crazyfrog-phongee/Project_1/IMAGES/setup-turbine.jpg

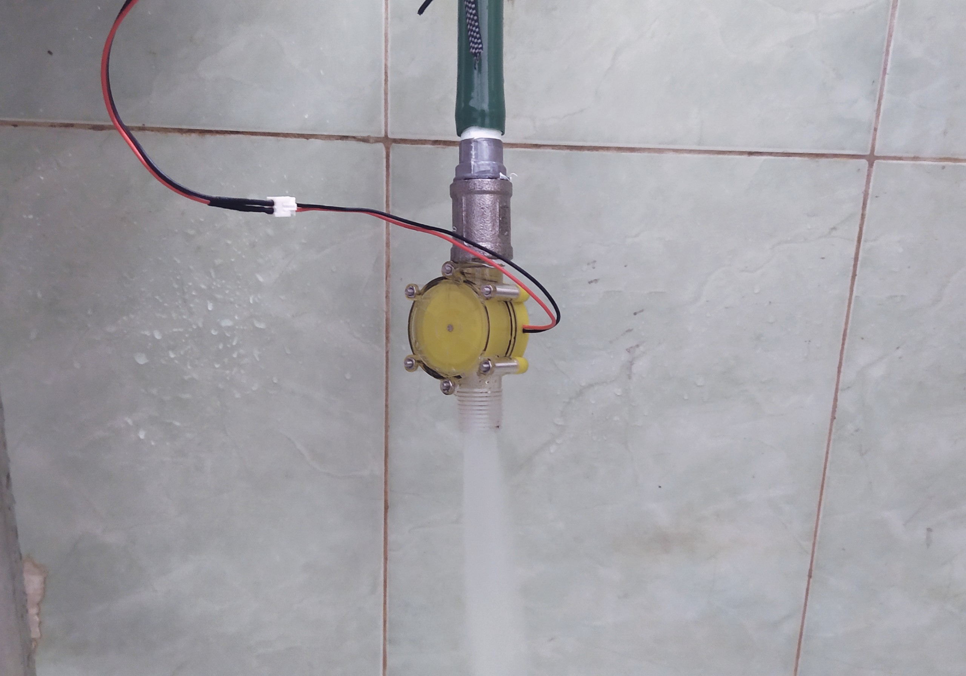
IMAGES/setup-turbine.jpg
