crazyfrog-phongee/Project_1/IMAGES/test-tuabin-voltage.jpg

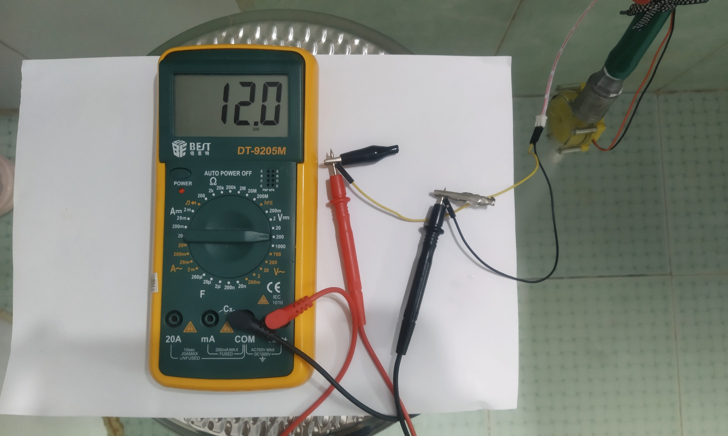
IMAGES/test-tuabin-voltage.jpg
