crazyfrog-phongee/Project_1/IMAGES/diagram.jpg

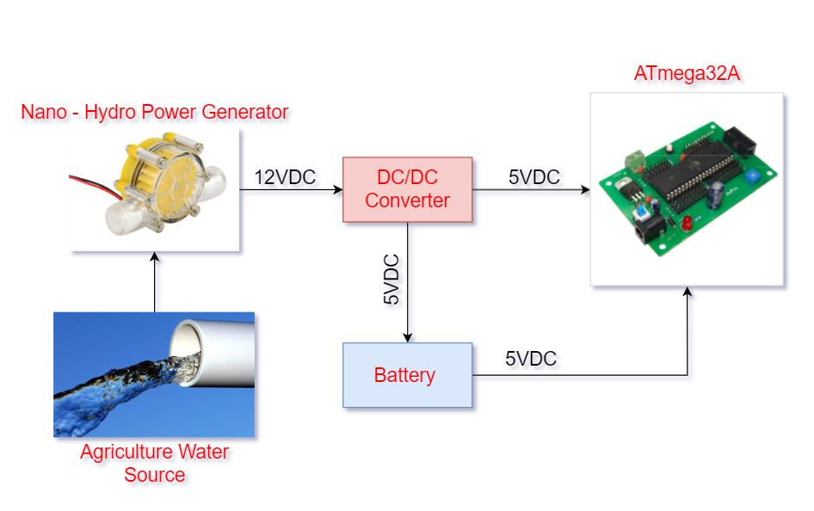
IMAGES/diagram.jpg
