crazyfrog-phongee/Project_1/IMAGES/hienthilcd.jpg

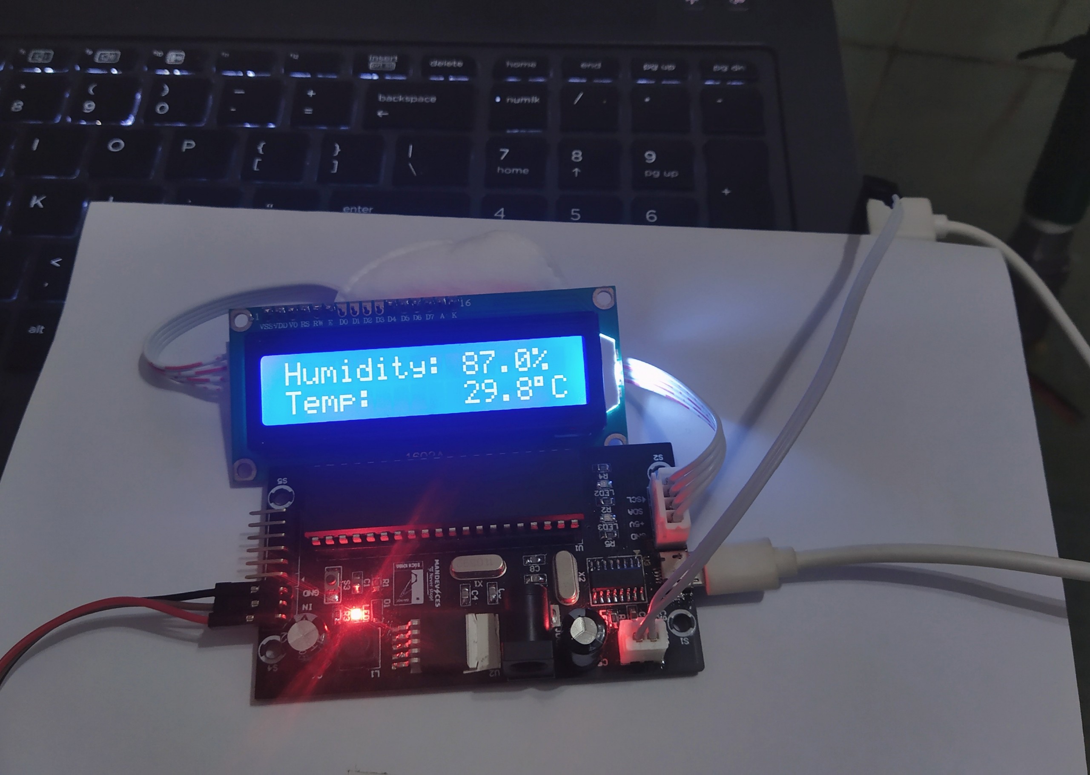
IMAGES/hienthilcd.jpg
