crazyfrog-phongee/Project_1/IMAGES/task_9.5.2022.jpg

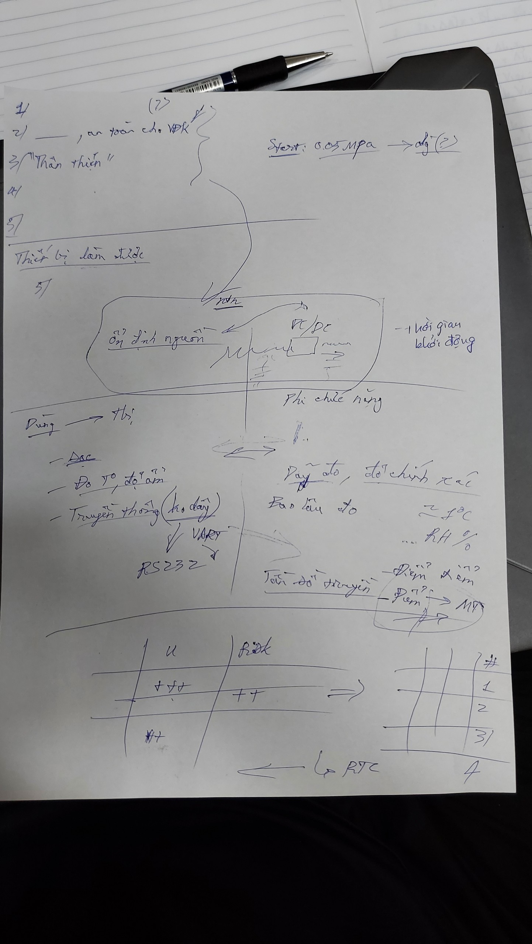
IMAGES/task_9.5.2022.jpg
