crazyfrog-phongee/Project_1/IMAGES/uart.jpg

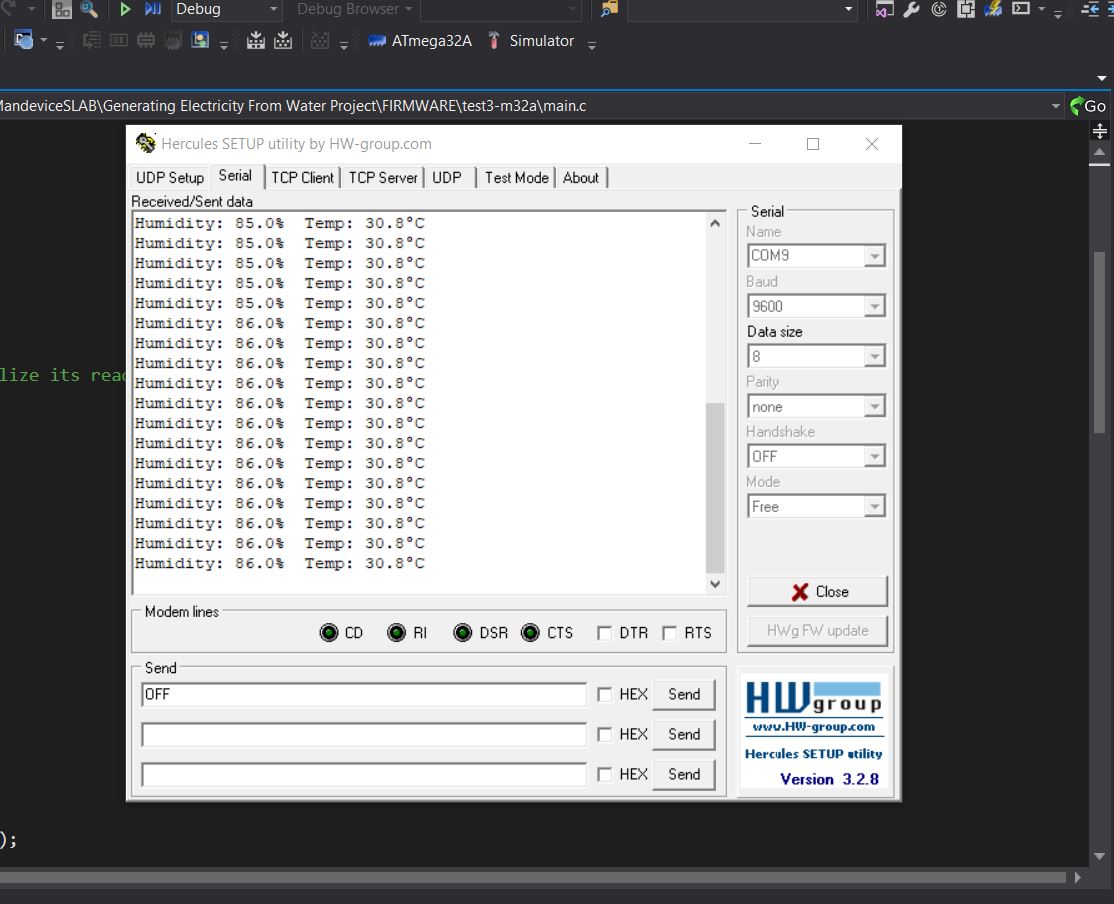
IMAGES/uart.jpg
