crazyfrog-phongee/Project_1/HARDWARE/list-components.xlsx

Danh sách linh kiện
STT | Khối | Tên linh kiện | Số lượng | Link
 | Nguồn
1 |  | Tuabin mini DC 12V/10W | 1 | https://shopee.vn/M%C3%A1y-ph%C3%A1t-%C4%91i%E1%BB%87n-chuy%E1%BB%83n-%C4%91%E1%BB%95i-tuabin-mini-ch%E1%BA%A1y-b%E1%BA%B1ng-s%E1%BB%A9c-n%C6%B0%E1%BB%9Bc-DC-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
2 |  | Module hạ áp Buck DC-DC LM2596 3A | 1 | https://chotroihn.vn/module-buck-dc-dc-lm2596-3a-k1a9-1-10g
3 |  | LM2596S SMD | 1 | https://linhkien.cxt.vn/3384-lm2596s-50-to-263-chinh-hang.html/page-5
4 |  | Jac DC 5.5x2.1mm | 2 | https://linhkien.cxt.vn/1331-jack-dc-55-21mm.html
5 |  | Tụ hóa 100uF 50V | 10 | https://linhkien.cxt.vn/2738-tu-hoa-100uf-50v-8x12mm.html
6 |  | Tụ hóa 220uF 50V | 5 | https://linhkien.cxt.vn/2524-tu-hoa-220uf-50v-8x12mm.html
7 |  | Cuộn cảm 33uH | 5 | https://linhkien.cxt.vn/1175-cd74r-33uh-2a.html
8 |  | Trở 1k5 | 1 dây | https://linhkien.cxt.vn/1056-dien-tro-1k-0805-5-50c.html
 | Truyền thông | USB TO COM CH340 | 1 | https://chotroihn.vn/usb-to-com-ch340
1 |  | IC CH340G | 2 | https://linhkien.cxt.vn/3958-ch340g-ic-transceiver-2mbps-usb20-sop-16.html
2 |  | LED đỏ SMD | 1 dây | https://linhkien.cxt.vn/1306-led-0805-red-trong-suot-10c.html
3 |  | LED xanh dương SMD | 1 dây
4 |  | LED xanh lá cây SMD | 1 dây
5 |  | Cổng USB 2.0 mini | 2 | https://linhkien.cxt.vn/1138-mini-usb-fb-connector.html
6 |  | Crystal 12MHz | 2 | https://linhkien.cxt.vn/1368-thach-anh-12mhz-dip-49s.html
1 | MCU | ATmega16PU | 1 | https://linhkien.cxt.vn/4369-atmega16-16pu-ic-mcu-8bit-16kb-flash-40dip.html
2 |  | Crystal 11.0592MHz | 2
3 |  | 22pF SMD | 1 dây | https://linhkien.cxt.vn/1061-tu-22pf-5-0805.html
4 |  | Resistor 10k SMD 0805 | 1 dây | https://linhkien.cxt.vn/1057-dien-tro-10k-5-0805.html
5 |  | Đế IC 40P | 2 | https://linhkien.cxt.vn/1322-dip-socket-40p.html
6 |  | Tụ 106 SMD | 1 dây | https://linhkien.cxt.vn/1978-tu-khong-phan-cuc-0805.html
7 |  | Nút nhấn 2 chân SMD | 2 | https://linhkien.cxt.vn/5070-nut-nhan-2p-3x4x25h-smd.html
8 |  | Jump đực đơn 1x40P | 1 | https://linhkien.cxt.vn/3907-jump-duc-don-1x40p-254mm-chan-cong-ma-vang.html
9 |  | Header đực 4P | 10 | https://banlinhkien.com/header-4p-xh2.544p-duc-thang-10-chiec-p22290875.html
10 |  | Tụ 104 SMD | 1 gói | https://linhkien.cxt.vn/1974-tu-khong-phan-cuc-0805.html
 |  | Diode 1n5819 | 1 | https://banlinhkien.com/diode-s4-sod123-1n5819-sod123-10c-p16133952.html
 |  | Dây trắng 4P XH2.54-4P 20Cm | 1 | https://banlinhkien.com/day-trang-4p-xh2.544p-20cm-p20816954.html
 |  | MicroUSB MK5P SMD | 1 | https://banlinhkien.com/microusb-mk5p-smd-p6652832.html
