crazyfrog-phongee/Project_1/IMAGES/setup.jpg

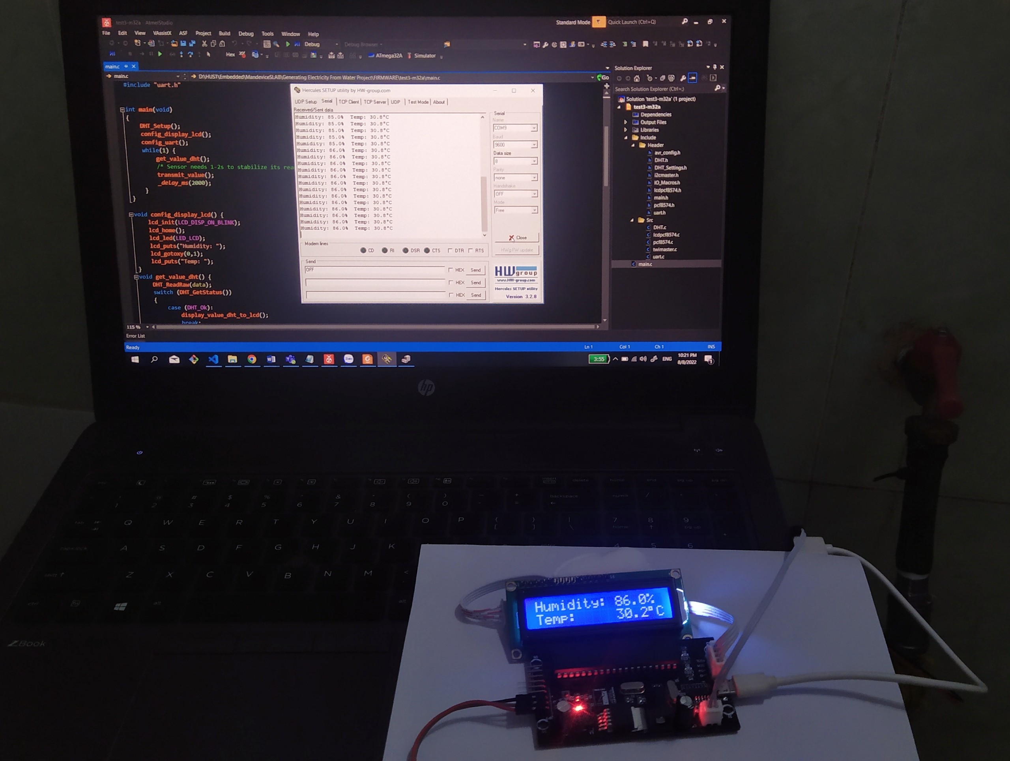
IMAGES/setup.jpg
