crazyfrog-phongee/Project_1/(list of files, drawings)

Other design files:
HARDWARE/Master_Display.SchDoc
HARDWARE/Master_MCU.SchDoc
HARDWARE/Master_Power.SchDoc
HARDWARE/Master_Sensor.SchDoc
HARDWARE/Master_Transmit.SchDoc
HARDWARE/PCB_Project1.PcbDoc
HARDWARE/PCB_Project1.PrjPCB
HARDWARE/Sheet-Connectors.SchDoc
PROTEUS/project-01.pdsprj
