crazyfrog-phongee/Project_1/FIRMWARE/firmware-project-1/Include/Src/lcdpcf8574.c

/*
 * lcdpcf8574 lib 0x03
 * copyright (c) Davide Gironi, 2013
 * Released under GPLv3.
 * Please refer to LICENSE file for licensing information.
*/

#include "avr_config.h"
#include <inttypes.h>
#include <avr/io.h>
#include <avr/pgmspace.h>

#include "pcf8574.h"
#include "lcdpcf8574.h"

#define lcd_e_delay()   __asm__ __volatile__( "rjmp 1f\n 1:" );
#define lcd_e_toggle()  toggle_e()

#if LCD_LINES==1
#define LCD_FUNCTION_DEFAULT    LCD_FUNCTION_4BIT_1LINE 
#else
#define LCD_FUNCTION_DEFAULT    LCD_FUNCTION_4BIT_2LINES 
#endif

volatile uint8_t dataport = 0;

/* 
** function prototypes 
*/
static void toggle_e(void);

/*
** local functions
*/



/*************************************************************************
 delay loop for small accurate delays: 16-bit counter, 4 cycles/loop
*************************************************************************/
static inline void _delayFourCycles(unsigned int __count)
{
    if ( __count == 0 )    
        __asm__ __volatile__( "rjmp 1f\n 1:" );    // 2 cycles
    else
        __asm__ __volatile__ (
    	    "1: sbiw %0,1" "\n\t"                  
    	    "brne 1b"                              // 4 cycles/loop
    	    : "=w" (__count)
    	    : "0" (__count)
    	   );
}


/************************************************************************* 
delay for a minimum of <us> microseconds
the number of loops is calculated at compile-time from MCU clock frequency
*************************************************************************/
#define delay(us)  _delayFourCycles( ( ( 1*(F_CPU/4000) )*us)/1000 )


/* toggle Enable Pin to initiate write */
static void toggle_e(void)
{
	pcf8574_setoutputpinhigh(LCD_PCF8574_DEVICEID, LCD_E_PIN);
    lcd_e_delay();
    pcf8574_setoutputpinlow(LCD_PCF8574_DEVICEID, LCD_E_PIN);
}


/*************************************************************************
Low-level function to write byte to LCD controller
Input:    data   byte to write to LCD
          rs     1: write data    
                 0: write instruction
Returns:  none
*************************************************************************/
static void lcd_write(uint8_t data,uint8_t rs) 
{
	if (rs) /* write data        (RS=1, RW=0) */
		dataport |= _BV(LCD_RS_PIN);
	else /* write instruction (RS=0, RW=0) */
		dataport &= ~_BV(LCD_RS_PIN);
	dataport &= ~_BV(LCD_RW_PIN);
	pcf8574_setoutput(LCD_PCF8574_DEVICEID, dataport);

	/* output high nibble first */
    dataport &= ~_BV(LCD_DATA3_PIN);
    dataport &= ~_BV(LCD_DATA2_PIN);
    dataport &= ~_BV(LCD_DATA1_PIN);
    dataport &= ~_BV(LCD_DATA0_PIN);
	if(data & 0x80) dataport |= _BV(LCD_DATA3_PIN);
	if(data & 0x40) dataport |= _BV(LCD_DATA2_PIN);
	if(data & 0x20) dataport |= _BV(LCD_DATA1_PIN);
	if(data & 0x10) dataport |= _BV(LCD_DATA0_PIN);
	pcf8574_setoutput(LCD_PCF8574_DEVICEID, dataport);
	lcd_e_toggle();

	/* output low nibble */
	dataport &= ~_BV(LCD_DATA3_PIN);
	dataport &= ~_BV(LCD_DATA2_PIN);
	dataport &= ~_BV(LCD_DATA1_PIN);
	dataport &= ~_BV(LCD_DATA0_PIN);
	if(data & 0x08) dataport |= _BV(LCD_DATA3_PIN);
	if(data & 0x04) dataport |= _BV(LCD_DATA2_PIN);
	if(data & 0x02) dataport |= _BV(LCD_DATA1_PIN);
	if(data & 0x01) dataport |= _BV(LCD_DATA0_PIN);
	pcf8574_setoutput(LCD_PCF8574_DEVICEID, dataport);
	lcd_e_toggle();

	/* all data pins high (inactive) */
	dataport |= _BV(LCD_DATA0_PIN);
	dataport |= _BV(LCD_DATA1_PIN);
	dataport |= _BV(LCD_DATA2_PIN);
	dataport |= _BV(LCD_DATA3_PIN);
	pcf8574_setoutput(LCD_PCF8574_DEVICEID, dataport);
}


/*************************************************************************
Low-level function to read byte from LCD controller
Input:    rs     1: read data    
                 0: read busy flag / address counter
Returns:  byte read from LCD controller
*************************************************************************/
static uint8_t lcd_read(uint8_t rs) 
{
    uint8_t data;

    if (rs) /* write data (RS=1, RW=0) */
    	dataport |= _BV(LCD_RS_PIN);
    else /* write instruction (RS=0, RW=0) */
    	dataport &= ~_BV(LCD_RS_PIN);
    dataport |= _BV(LCD_RW_PIN);
    pcf8574_setoutput(LCD_PCF8574_DEVICEID, dataport);

	/* read high nibble first */
    pcf8574_setoutputpinhigh(LCD_PCF8574_DEVICEID, LCD_E_PIN);
	lcd_e_delay();
    data = 0;
    if(!pcf8574_getinputpin(LCD_PCF8574_DEVICEID, LCD_DATA0_PIN)) data |= 0x10;
    if(!pcf8574_getinputpin(LCD_PCF8574_DEVICEID, LCD_DATA1_PIN)) data |= 0x20;
    if(!pcf8574_getinputpin(LCD_PCF8574_DEVICEID, LCD_DATA2_PIN)) data |= 0x40;
    if(!pcf8574_getinputpin(LCD_PCF8574_DEVICEID, LCD_DATA3_PIN)) data |= 0x80;
	pcf8574_setoutputpinlow(LCD_PCF8574_DEVICEID, LCD_E_PIN);

	/* Enable 500ns low */
	lcd_e_delay();

	/* read low nibble */
	pcf8574_setoutputpinhigh(LCD_PCF8574_DEVICEID, LCD_E_PIN);
	lcd_e_delay();
	if(!pcf8574_getinputpin(LCD_PCF8574_DEVICEID, LCD_DATA0_PIN)) data |= 0x01;
	if(!pcf8574_getinputpin(LCD_PCF8574_DEVICEID, LCD_DATA1_PIN)) data |= 0x02;
	if(!pcf8574_getinputpin(LCD_PCF8574_DEVICEID, LCD_DATA2_PIN)) data |= 0x04;
	if(!pcf8574_getinputpin(LCD_PCF8574_DEVICEID, LCD_DATA3_PIN)) data |= 0x08;
	pcf8574_setoutputpinlow(LCD_PCF8574_DEVICEID, LCD_E_PIN);

    return data;
}


/*************************************************************************
loops while lcd is busy, returns address counter
*************************************************************************/
static uint8_t lcd_waitbusy(void)
{
    register uint8_t c;
    
    /* wait until busy flag is cleared */
    while ( (c=lcd_read(0)) & (1<<LCD_BUSY)) {}
    
    /* the address counter is updated 4us after the busy flag is cleared */
    delay(2);

    /* now read the address counter */
    return (lcd_read(0));  // return address counter
    
}/* lcd_waitbusy */


/*************************************************************************
Move cursor to the start of next line or to the first line if the cursor 
is already on the last line.
*************************************************************************/
static inline void lcd_newline(uint8_t pos)
{
    register uint8_t addressCounter;


#if LCD_LINES==1
    addressCounter = 0;
#endif
#if LCD_LINES==2
    if ( pos < (LCD_START_LINE2) )
        addressCounter = LCD_START_LINE2;
    else
        addressCounter = LCD_START_LINE1;
#endif
#if LCD_LINES==4
    if ( pos < LCD_START_LINE3 )
        addressCounter = LCD_START_LINE2;
    else if ( (pos >= LCD_START_LINE2) && (pos < LCD_START_LINE4) )
        addressCounter = LCD_START_LINE3;
    else if ( (pos >= LCD_START_LINE3) && (pos < LCD_START_LINE2) )
        addressCounter = LCD_START_LINE4;
    else 
        addressCounter = LCD_START_LINE1;
#endif
    lcd_command((1<<LCD_DDRAM)+addressCounter);

}/* lcd_newline */


/*
** PUBLIC FUNCTIONS 
*/

/*************************************************************************
Send LCD controller instruction command
Input:   instruction to send to LCD controller, see HD44780 data sheet
Returns: none
*************************************************************************/
void lcd_command(uint8_t cmd)
{
    lcd_waitbusy();
    lcd_write(cmd,0);
}


/*************************************************************************
Send data byte to LCD controller 
Input:   data to send to LCD controller, see HD44780 data sheet
Returns: none
*************************************************************************/
void lcd_data(uint8_t data)
{
    lcd_waitbusy();
    lcd_write(data,1);
}


/*************************************************************************
Clear CGRAM
*************************************************************************/
void lcd_clear_CGRAM() {
	register uint8_t addressCounter = 0;
	for (; addressCounter < 64; addressCounter++) {
		lcd_command((1 << LCD_CGRAM) + addressCounter);
		lcd_putc(0x00);
	}
}


/*************************************************************************
Define custom character in CGRAM
Inputs: charnum: Character position in CGRAM. You can define maximum 8 chars.
values[]: Custom character descriptor pointer.
Returns: 0 - The custom character successfully created
1 - If the charnum greater than 7. You can define maximum 8 chars.
*************************************************************************/
uint8_t lcd_create_custom_char(uint8_t charnum, const uint8_t * values) {
	register uint8_t j = 0;
	const uint8_t *p = values;

	if (charnum > 7) {
		return 1;
	}
	lcd_command((1 << LCD_CGRAM) + charnum * 8); // set CGRAM address charnum * 8 byte
	for (; j < 8; j++) {
		lcd_putc (*(p + j)); // write 8 byte data (one character) to CGRAM
	}
	return (0);
}


/*************************************************************************
Set cursor to specified position
Input:    x  horizontal position  (0: left most position)
          y  vertical position    (0: first line)
Returns:  none
*************************************************************************/
void lcd_gotoxy(uint8_t x, uint8_t y)
{
#if LCD_LINES==1
    lcd_command((1<<LCD_DDRAM)+LCD_START_LINE1+x);
#endif
#if LCD_LINES==2
    if ( y==0 ) 
        lcd_command((1<<LCD_DDRAM)+LCD_START_LINE1+x);
    else
        lcd_command((1<<LCD_DDRAM)+LCD_START_LINE2+x);
#endif
#if LCD_LINES==4
    if ( y==0 )
        lcd_command((1<<LCD_DDRAM)+LCD_START_LINE1+x);
    else if ( y==1)
        lcd_command((1<<LCD_DDRAM)+LCD_START_LINE2+x);
    else if ( y==2)
        lcd_command((1<<LCD_DDRAM)+LCD_START_LINE3+x);
    else /* y==3 */
        lcd_command((1<<LCD_DDRAM)+LCD_START_LINE4+x);
#endif

}/* lcd_gotoxy */


/*************************************************************************
*************************************************************************/
int lcd_getxy(void)
{
    return lcd_waitbusy();
}


/*************************************************************************
Clear display and set cursor to home position
*************************************************************************/
void lcd_clrscr(void)
{
    lcd_command(1<<LCD_CLR);
}


/*************************************************************************
Set illumination pin
*************************************************************************/
void lcd_led(uint8_t onoff)
{
	if(onoff)
		dataport &= ~_BV(LCD_LED_PIN);
	else
		dataport |= _BV(LCD_LED_PIN);
	pcf8574_setoutput(LCD_PCF8574_DEVICEID, dataport);
}


/*************************************************************************
Set cursor to home position
*************************************************************************/
void lcd_home(void)
{
    lcd_command(1<<LCD_HOME);
}


/*************************************************************************
Display character at current cursor position 
Input:    character to be displayed                                       
Returns:  none
*************************************************************************/
void lcd_putc(char c)
{
    uint8_t pos;

    pos = lcd_waitbusy();   // read busy-flag and address counter
    if (c=='\n')
    {
        lcd_newline(pos);
    }
    else
    {
#if LCD_WRAP_LINES==1
#if LCD_LINES==1
        if ( pos == LCD_START_LINE1+LCD_DISP_LENGTH ) {
            lcd_write((1<<LCD_DDRAM)+LCD_START_LINE1,0);
        }
#elif LCD_LINES==2
        if ( pos == LCD_START_LINE1+LCD_DISP_LENGTH ) {
            lcd_write((1<<LCD_DDRAM)+LCD_START_LINE2,0);    
        }else if ( pos == LCD_START_LINE2+LCD_DISP_LENGTH ){
            lcd_write((1<<LCD_DDRAM)+LCD_START_LINE1,0);
        }
#elif LCD_LINES==4
        if ( pos == LCD_START_LINE1+LCD_DISP_LENGTH ) {
            lcd_write((1<<LCD_DDRAM)+LCD_START_LINE2,0);    
        }else if ( pos == LCD_START_LINE2+LCD_DISP_LENGTH ) {
            lcd_write((1<<LCD_DDRAM)+LCD_START_LINE3,0);
        }else if ( pos == LCD_START_LINE3+LCD_DISP_LENGTH ) {
            lcd_write((1<<LCD_DDRAM)+LCD_START_LINE4,0);
        }else if ( pos == LCD_START_LINE4+LCD_DISP_LENGTH ) {
            lcd_write((1<<LCD_DDRAM)+LCD_START_LINE1,0);
        }
#endif
        lcd_waitbusy();
#endif
        lcd_write(c, 1);
    }

}/* lcd_putc */


/*************************************************************************
Display string without auto linefeed 
Input:    string to be displayed
Returns:  none
*************************************************************************/
void lcd_puts(const char *s)
/* print string on lcd (no auto linefeed) */
{
    register char c;

    while ( (c = *s++) ) {
        lcd_putc(c);
    }

}/* lcd_puts */


/*************************************************************************
Display string from program memory without auto linefeed 
Input:     string from program memory be be displayed                                        
Returns:   none
*************************************************************************/
void lcd_puts_p(const char *progmem_s)
/* print string from program memory on lcd (no auto linefeed) */
{
    register char c;

    while ( (c = pgm_read_byte(progmem_s++)) ) {
        lcd_putc(c);
    }

}/* lcd_puts_p */


/*************************************************************************
Initialize display and select type of cursor 
Input:    dispAttr LCD_DISP_OFF            display off
                   LCD_DISP_ON             display on, cursor off
                   LCD_DISP_ON_CURSOR      display on, cursor on
                   LCD_DISP_CURSOR_BLINK   display on, cursor on flashing
Returns:  none
*************************************************************************/
void lcd_init(uint8_t dispAttr)
{
	#if LCD_PCF8574_INIT == 1
	//init pcf8574
	pcf8574_init();
	#endif

	dataport = 0;
	pcf8574_setoutput(LCD_PCF8574_DEVICEID, dataport);

	delay(16000);        /* wait 16ms or more after power-on       */

    /* initial write to lcd is 8bit */
    dataport |= _BV(LCD_DATA1_PIN);  // _BV(LCD_FUNCTION)>>4;
    dataport |= _BV(LCD_DATA0_PIN);  // _BV(LCD_FUNCTION_8BIT)>>4;
    pcf8574_setoutput(LCD_PCF8574_DEVICEID, dataport);

    lcd_e_toggle();
    delay(4992);         /* delay, busy flag can't be checked here */

    /* repeat last command */ 
    lcd_e_toggle();      
    delay(64);           /* delay, busy flag can't be checked here */
    
    /* repeat last command a third time */
    lcd_e_toggle();      
    delay(64);           /* delay, busy flag can't be checked here */

    /* now configure for 4bit mode */
    dataport &= ~_BV(LCD_DATA0_PIN);
    pcf8574_setoutput(LCD_PCF8574_DEVICEID, dataport);
    lcd_e_toggle();
    delay(64);           /* some displays need this additional delay */
    
    /* from now the LCD only accepts 4 bit I/O, we can use lcd_command() */    

    lcd_command(LCD_FUNCTION_DEFAULT);      /* function set: display lines  */

    lcd_command(LCD_DISP_OFF);              /* display off                  */
    lcd_clrscr();                           /* display clear                */
    lcd_command(LCD_MODE_DEFAULT);          /* set entry mode               */
    lcd_command(dispAttr);                  /* display/cursor control       */

}/* lcd_init */
