crazyfrog-phongee/Project_1/FIRMWARE/firmware-project-1/Include/Header/DHT_Settings.h

#ifndef DHT_SETTINGS_H_INCLUDED	
#define DHT_SETTINGS_H_INCLUDED
/*
||
||  Filename:	 		DHT_Settings.h
||  Title: 			    DHTxx Driver Settings
||  Author: 			Efthymios Koktsidis
||	Email:				efthymios.ks@gmail.com
||  Compiler:		 	AVR-GCC
||	Description:
||	Settings for the DHTxx driver. Pick a model 
||	and the desirable pin.
||
*/

//----- Configuration --------------------------//
#define DHT_Type	DHT11          //DHT11 or DHT22
#define DHT_Pin		D, 4
//----------------------------------------------//
#endif
