crazyfrog-phongee/Project_1/FIRMWARE/firmware-project-1/Include/Header/avr_config.h

/*
 * avr_config.h
 *
 * Created: 7/3/2022 12:26:55 PM
 *  Author: PhongEE & Manh
 */ 


#ifndef AVR_CONFIG_H_
#define AVR_CONFIG_H_


#define F_CPU 11059200UL
#define UART_BAUD_RATE 9600

#define ON			0
#define OFF			!ON

#define LED_LCD ON



#endif /* AVR_CONFIG_H_ */
